kurikennn/stirling-engine/cad/step/00_assembly.STEP

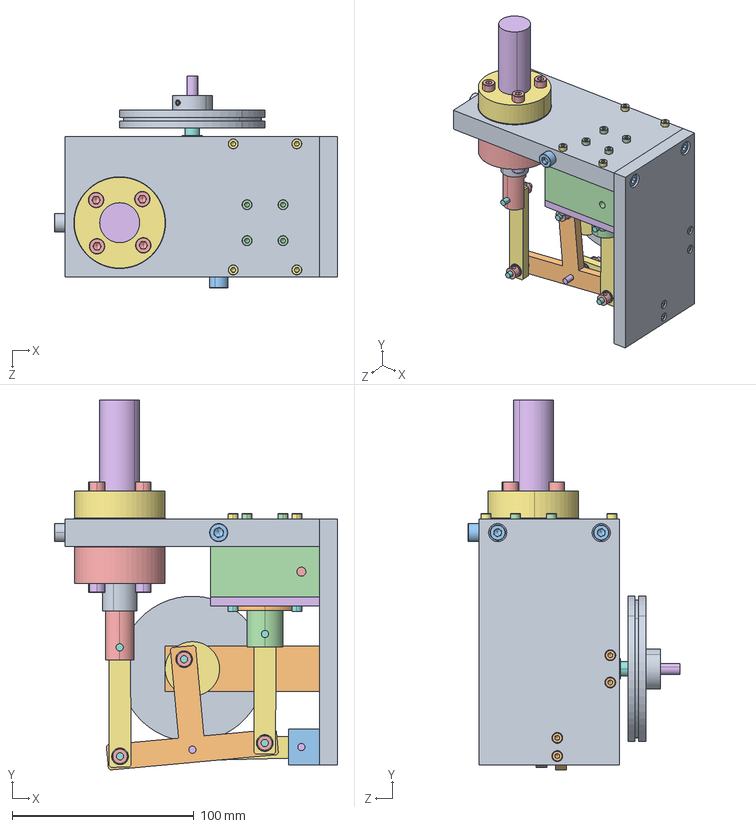
[picture p1: CAD file, 2026-09-30]
cad/step/00_assembly.STEP
156.0 x 203.7 x 116.8 mm
02_横板
09_低温部シリンダ
23_低温部ゴムパッキン
22_高温部ゴムパッキン x 2
06_高温部シリンダジャケット
07_加熱キャップ
05_加熱キャップジャケット
27_高温部シリンダ
01_ベース
11_中心軸-ベース接続部品
12_T字クランク拘束ロッド-ベース接続部品
10_低温部ピストン
08_高温部ピストンアダプタ
18_中心軸シャフト
04_クランクアーム
16_短シャフト x 5
MF84ZZ Outer Ring x 14
MF84ZZ Inner Ring x 14
MF84ZZ Shield1 x 14
MF84ZZ Ball x 168
MF84ZZ Shield2 x 14
MF106ZZ1 Outer Ring x 2
MF106ZZ1 Inner Ring x 2
MF106ZZ1 Shield1 x 2
MF106ZZ1 Ball x 32
MF106ZZ1 Shield2 x 2
20_中心軸スペーサ x 2
03_フライホイール
13_T字クランク
19_スペーサ x 3
31_シムリング x 11
32_ストッパ x 7
17_長シャフト x 2
15_ピストン駆動ロッド x 2
21_T字クランク側スペーサ x 2
14_T字クランク拘束ロッド
28_高温部ピストン
hexagon socket head cap screw_jis_JIS B 1176 M3 x 16 (16) --N x 4
hexagon socket head cap screw_jis_JIS B 1176 M5 x 16 (16) --N x 2
hexagon socket head cap screw_jis_JIS B 1176 M3 x 25 (18) --N x 4
hexagon socket head cap screw_jis_JIS B 1176 M5 x 20 (20) --N x 4
hexagon socket head cap screw_jis_JIS B 1176 M5 x 25 (25) --N x 4
hexagon socket set screw flat point_jis_JIS B 1177 Flat point M3 x 5 --N x 6
hexagon socket set screw flat point_jis_JIS B 1177 Flat point M3 x 12 --N
hexagon socket set screw flat point_jis_JIS B 1177 Flat point M3 x 6 --N
hexagon socket set screw flat point_jis_JIS B 1177 Flat point M4 x 8 --N
hexagon socket head cap screw_jis_JIS B 1176 M6 x 20 (20) --N
24_機構側水冷用板
25_ホイール側水冷用板
26_横板側水冷用板
hexagon socket head cap screw_jis_JIS B 1176 M3 x 20 (20) --N x 4
hexagon socket head cap screw_jis_JIS B 1176 M3 x 10 (10) --N x 4
hexagon socket head cap screw_jis_JIS B 1176 M6 x 25 (25) --N
