kurikennn/stirling-engine/cad/solidworks/32_ストッパ.SLDPRT

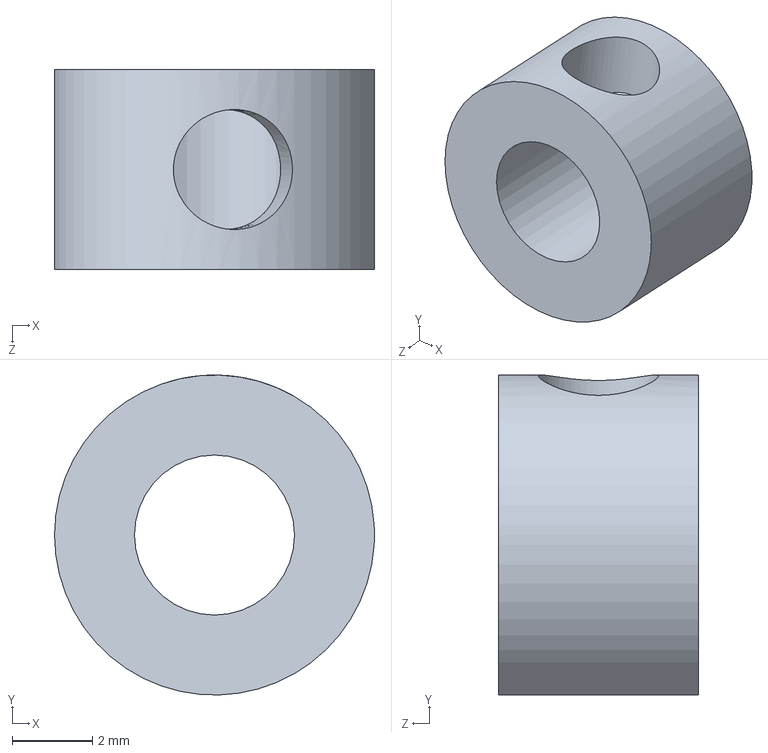
[picture p2: CAD file, 2026-09-30]
cad/solidworks/32_ストッパ.SLDPRT
8.00 x 8.00 x 5.00 mm
