kurikennn/stirling-engine/cad/step/18_center_shaft.STEP

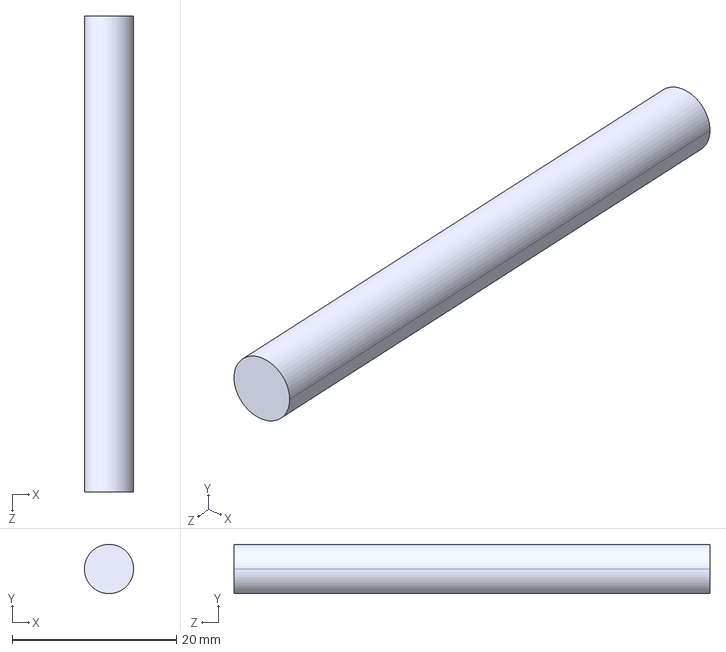
[picture p3: CAD file, 2026-09-30]
cad/step/18_center_shaft.STEP
6.00 x 6.00 x 58.0 mm
