kurikennn/stirling-engine/cad/step/07_heating_cap.STEP

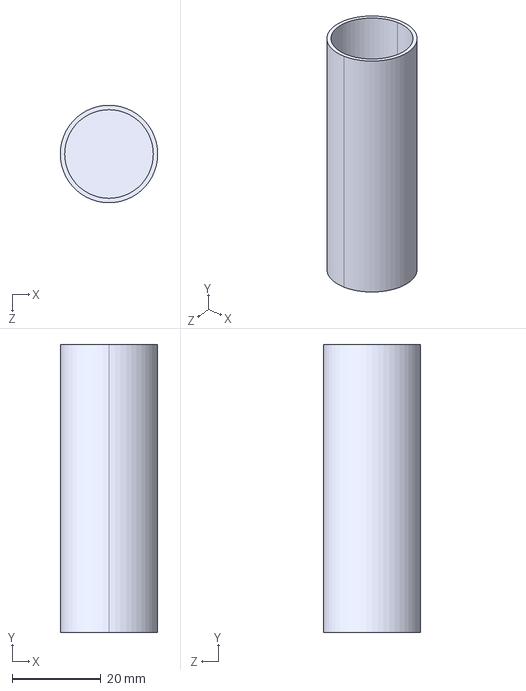
[picture p4: CAD file, 2026-09-30]
cad/step/07_heating_cap.STEP
22.0 x 65.0 x 22.0 mm
