kurikennn/stirling-engine/cad/solidworks/31_シムリング.SLDPRT

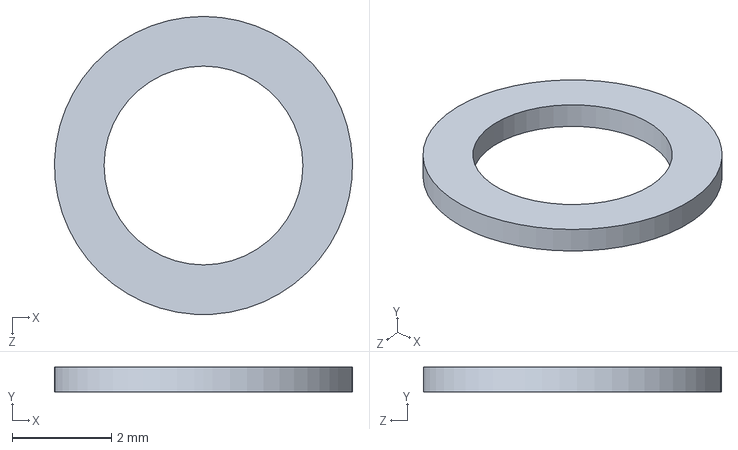
[picture p5: CAD file, 2026-09-30]
cad/solidworks/31_シムリング.SLDPRT
6.00 x 0.5 x 6.00 mm
