kurikennn/stirling-engine/cad/step/10_cold_piston.STEP

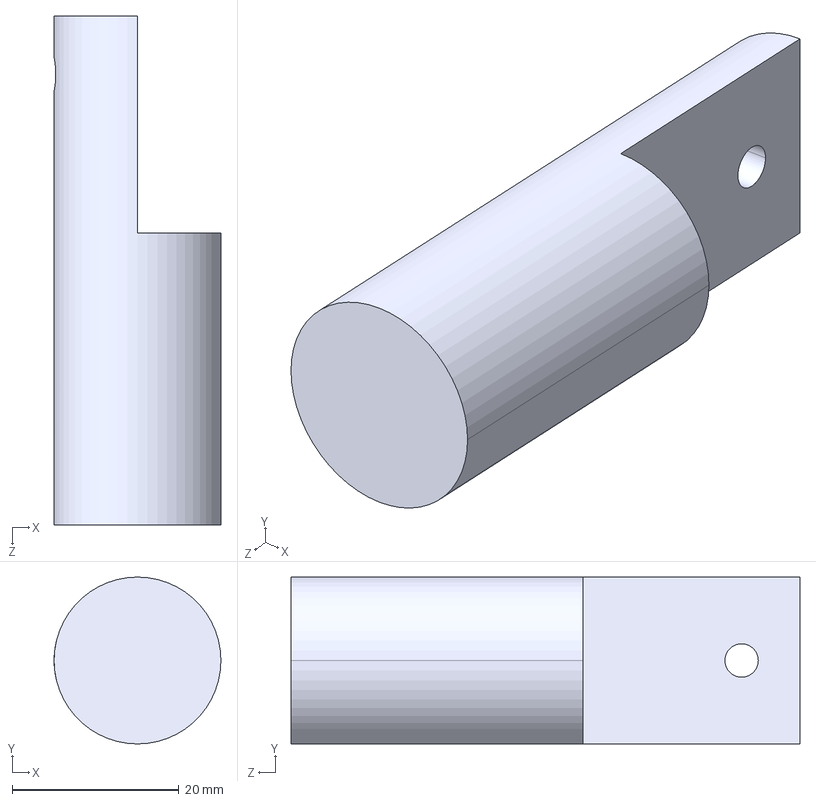
[picture p6: CAD file, 2026-09-30]
cad/step/10_cold_piston.STEP
20.0 x 20.0 x 61.0 mm
