kurikennn/stirling-engine/cad/step/20_center_spacer.STEP

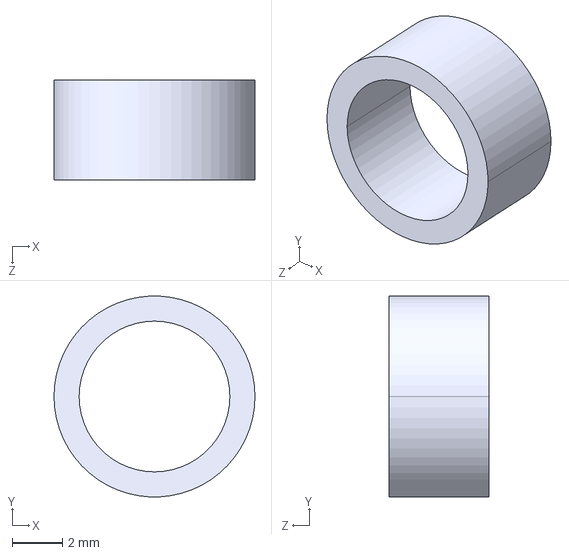
[picture p7: CAD file, 2026-09-30]
cad/step/20_center_spacer.STEP
8.00 x 7.99 x 4.00 mm
