kurikennn/stirling-engine/cad/step/01_base.STEP

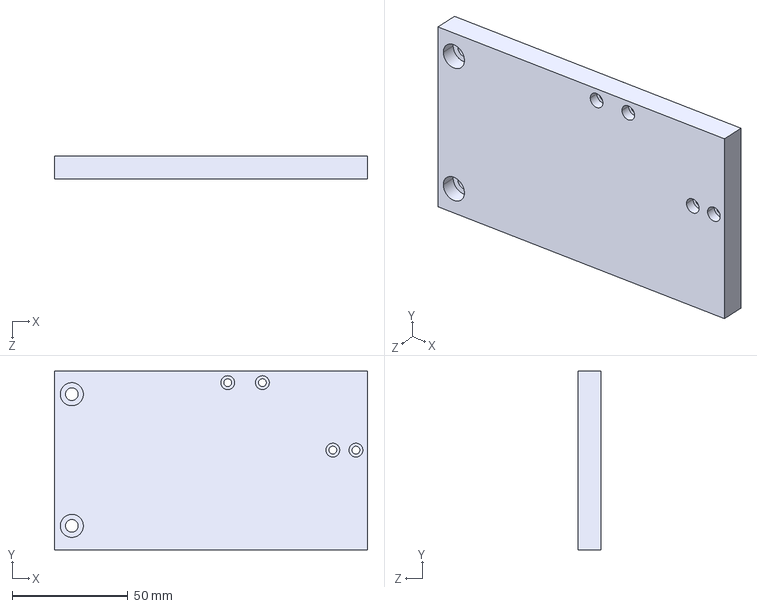
[picture p8: CAD file, 2026-09-30]
cad/step/01_base.STEP
135.5 x 77.4 x 10.0 mm
