kurikennn/stirling-engine/cad/step/12_t_crank_guide_rod_base_connector.STEP

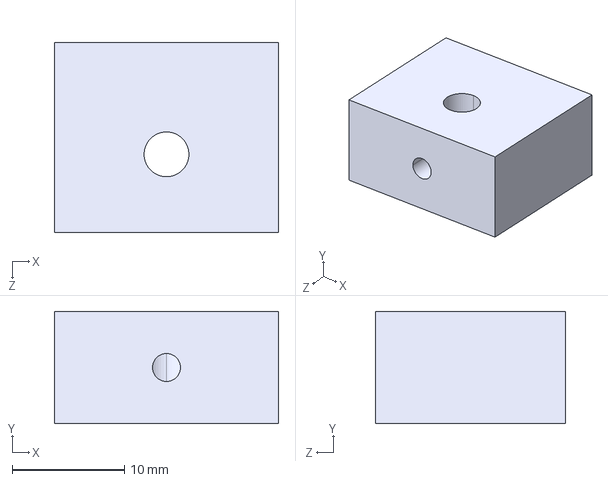
[picture p9: CAD file, 2026-09-30]
cad/step/12_t_crank_guide_rod_base_connector.STEP
20.0 x 10.0 x 17.0 mm
