kurikennn/stirling-engine/cad/step/05_heating_cap_jacket.STEP

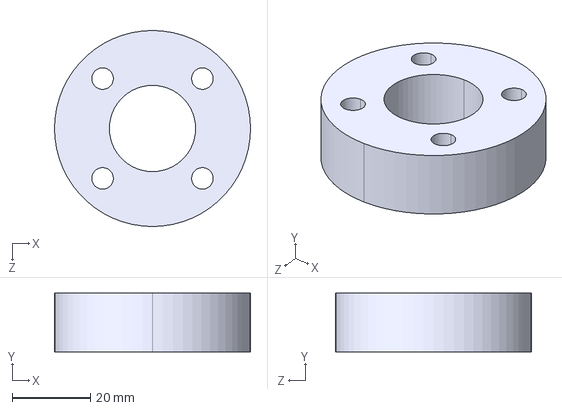
[picture p10: CAD file, 2026-09-30]
cad/step/05_heating_cap_jacket.STEP
50.0 x 15.0 x 50.0 mm
