kurikennn/stirling-engine/cad/step/25_water_cooling_plate_wheel_side.STEP

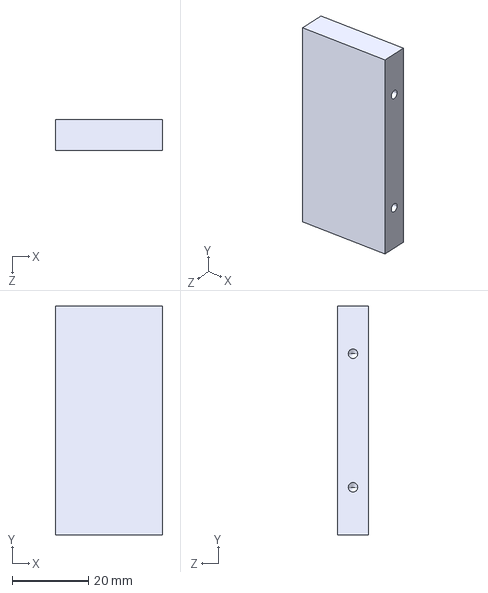
[picture p11: CAD file, 2026-09-30]
cad/step/25_water_cooling_plate_wheel_side.STEP
28.0 x 60.0 x 8.00 mm
