kurikennn/stirling-engine/cad/step/14_t_crank_guide_rod.STEP

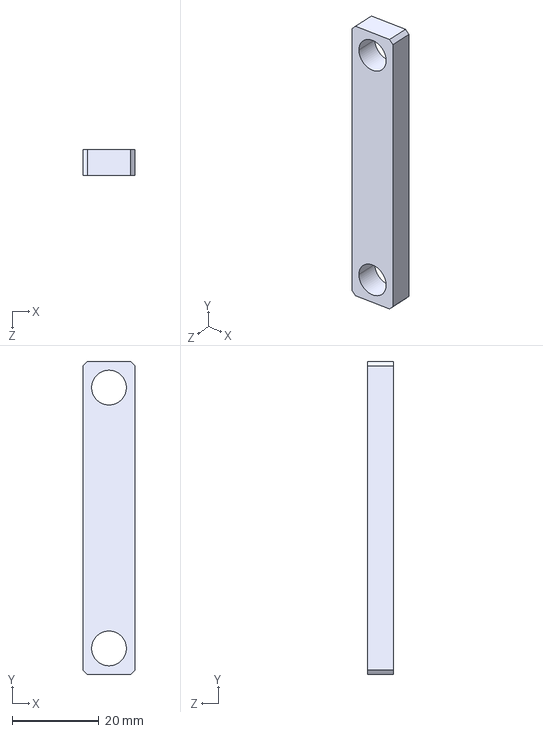
[picture p12: CAD file, 2026-09-30]
cad/step/14_t_crank_guide_rod.STEP
12.0 x 72.0 x 6.00 mm
