kurikennn/stirling-engine/cad/step/19_spacer.STEP

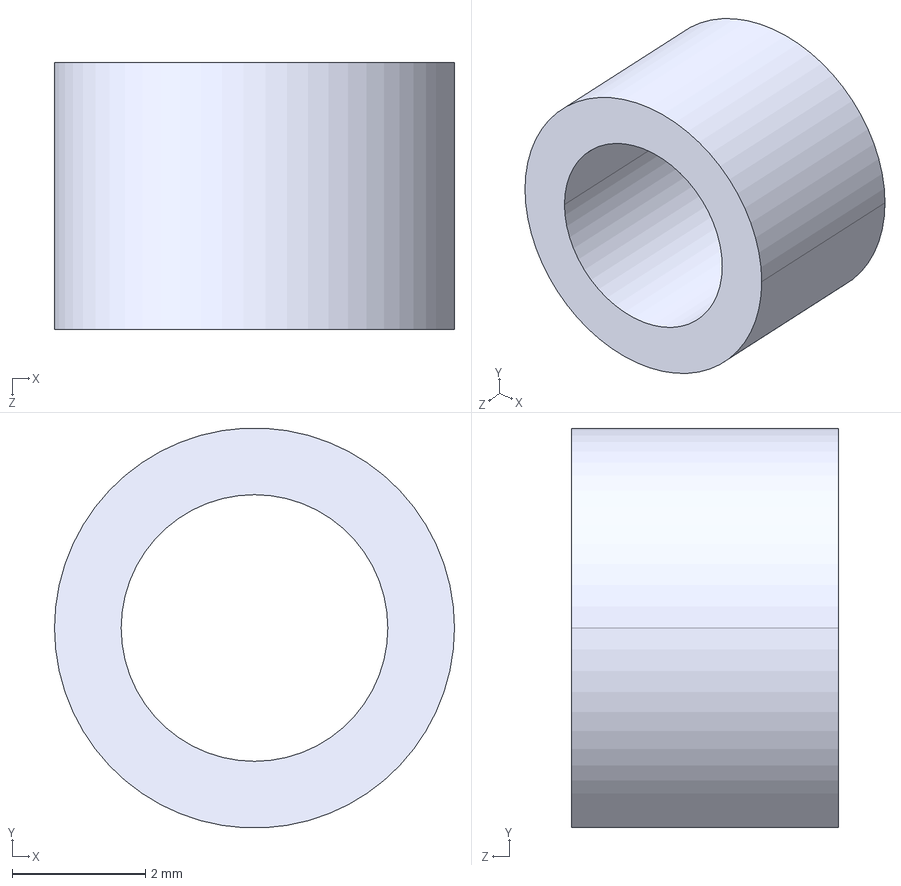
[picture p13: CAD file, 2026-09-30]
cad/step/19_spacer.STEP
6.00 x 5.99 x 4.00 mm
