kurikennn/stirling-engine/cad/step/21_spacer_t_crank_side.STEP

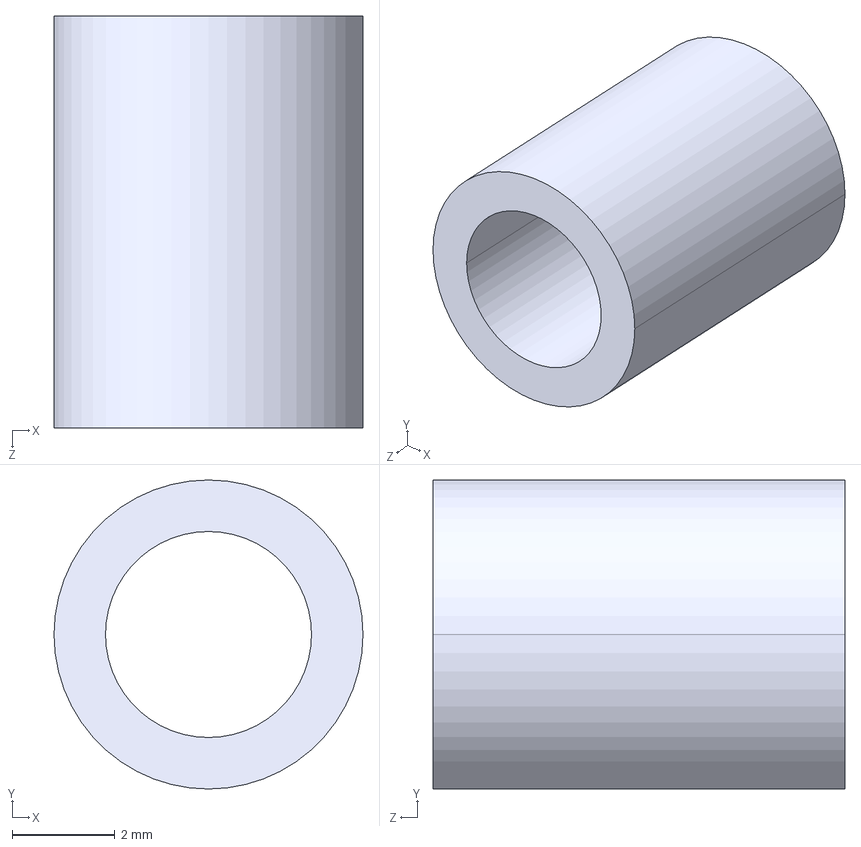
[picture p14: CAD file, 2026-09-30]
cad/step/21_spacer_t_crank_side.STEP
6.00 x 6.00 x 8.00 mm
