kurikennn/stirling-engine/cad/step/22_hot_seal.STEP

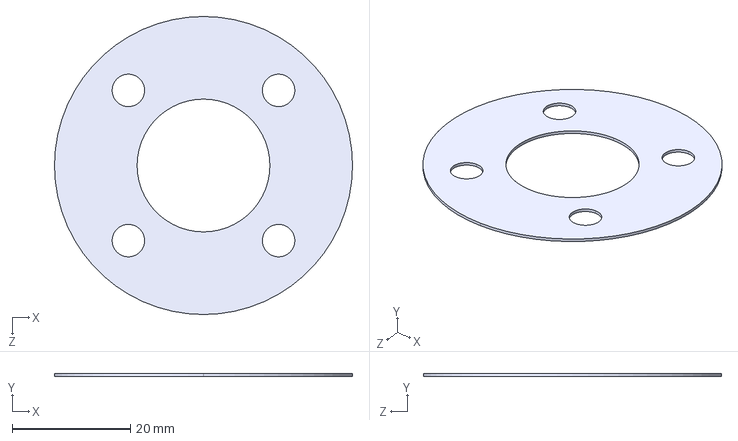
[picture p15: CAD file, 2026-09-30]
cad/step/22_hot_seal.STEP
50.5 x 0.5 x 50.5 mm
