kurikennn/stirling-engine/cad/step/16_shoft_shaft.STEP

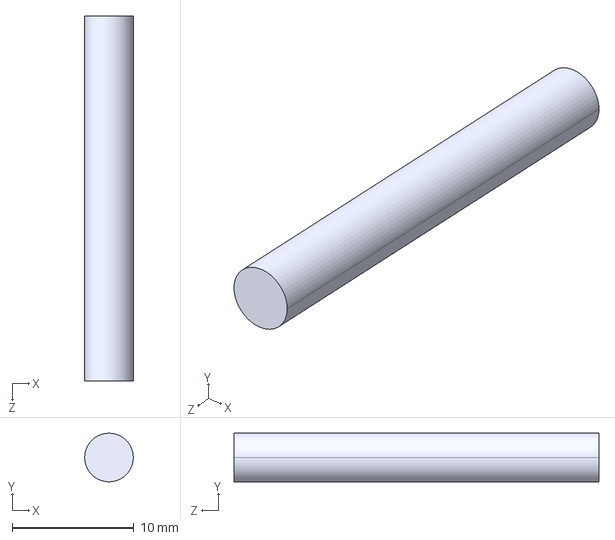
[picture p16: CAD file, 2026-09-30]
cad/step/16_shoft_shaft.STEP
4.00 x 4.00 x 30.0 mm
