kurikennn/stirling-engine/cad/step/04_crank_arm.STEP

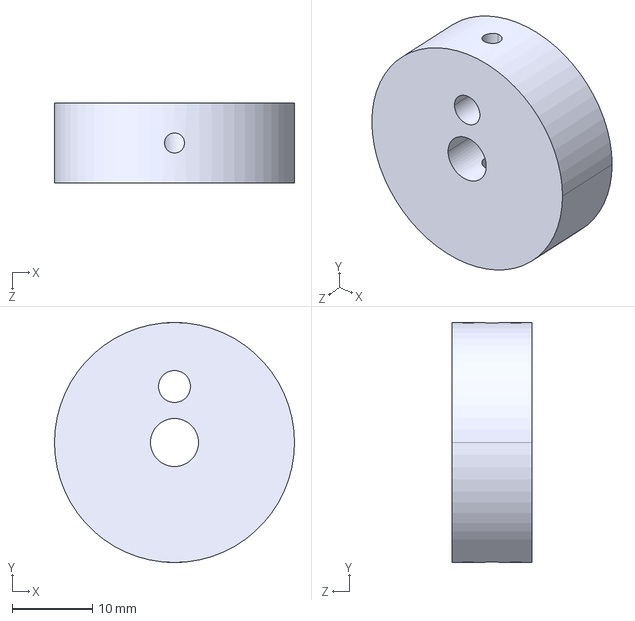
[picture p17: CAD file, 2026-09-30]
cad/step/04_crank_arm.STEP
30.0 x 30.0 x 10.0 mm
