kurikennn/stirling-engine/cad/step/03_flywheel.STEP

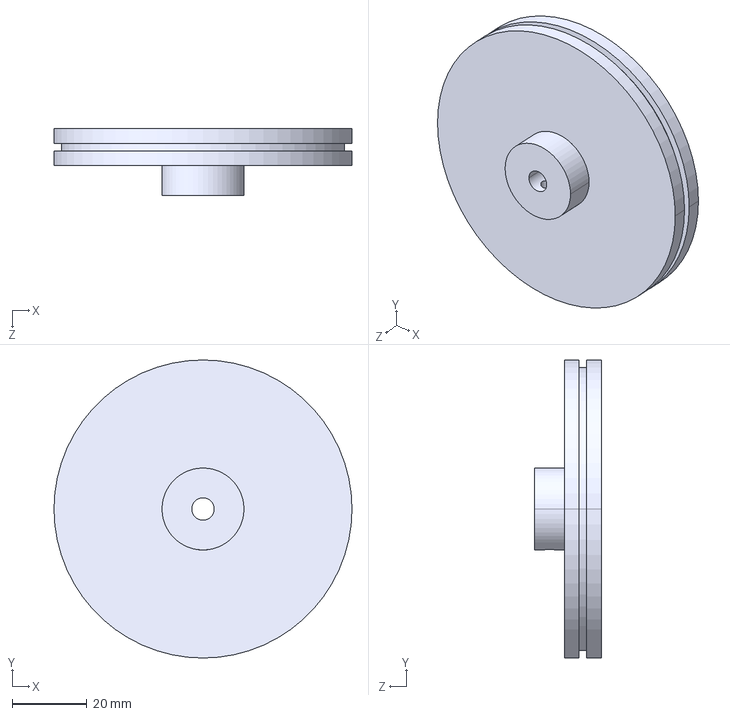
[picture p18: CAD file, 2026-09-30]
cad/step/03_flywheel.STEP
80.0 x 80.0 x 18.0 mm
