kurikennn/stirling-engine/cad/step/27_hot_cylinder.STEP

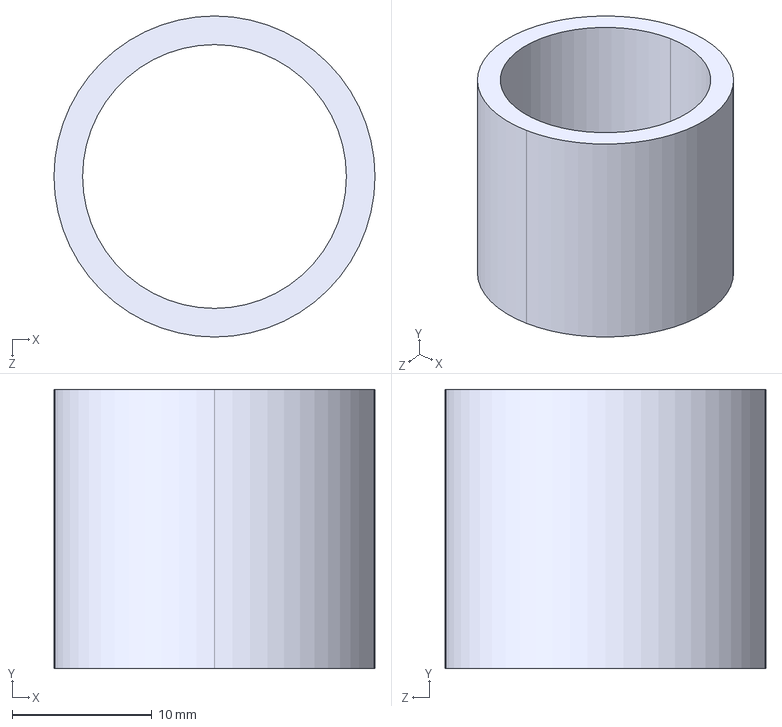
[picture p19: CAD file, 2026-09-30]
cad/step/27_hot_cylinder.STEP
23.0 x 20.0 x 23.0 mm
