kurikennn/stirling-engine/cad/step/02_side_plate.STEP

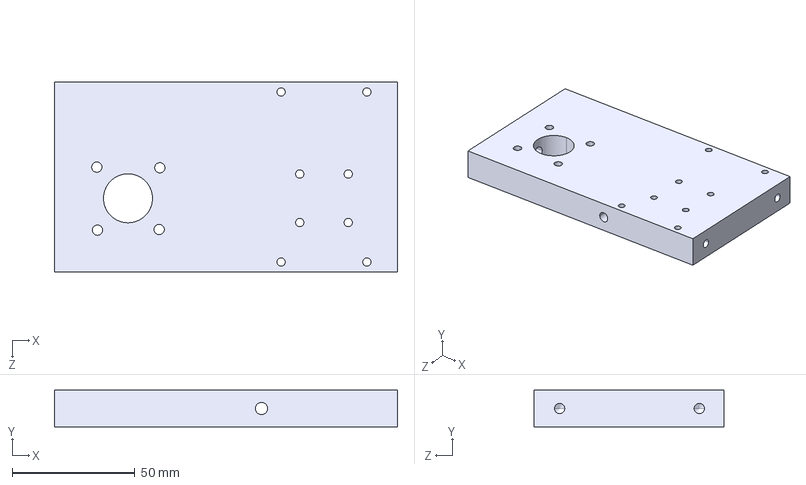
[picture p20: CAD file, 2026-09-30]
cad/step/02_side_plate.STEP
140.0 x 15.0 x 77.4 mm
