kurikennn/stirling-engine/cad/step/11_center_shaft_base_connector.STEP

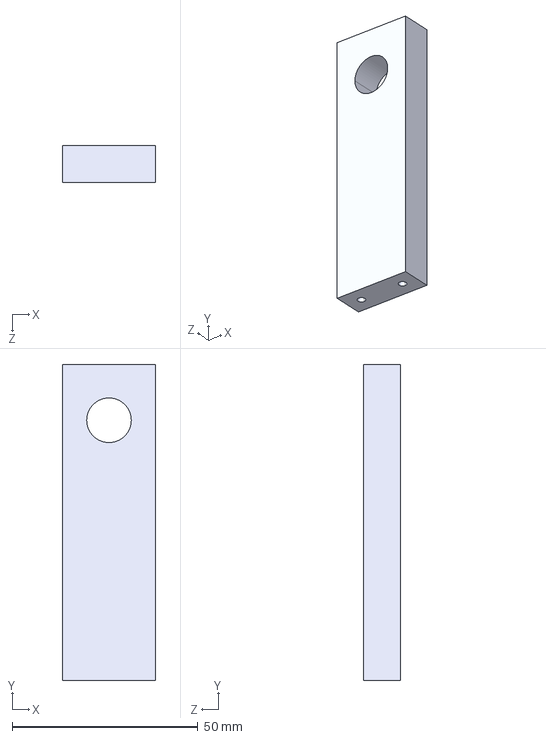
[picture p21: CAD file, 2026-09-30]
cad/step/11_center_shaft_base_connector.STEP
25.0 x 85.0 x 10.0 mm
