kurikennn/stirling-engine/cad/step/28_hot_piston.STEP

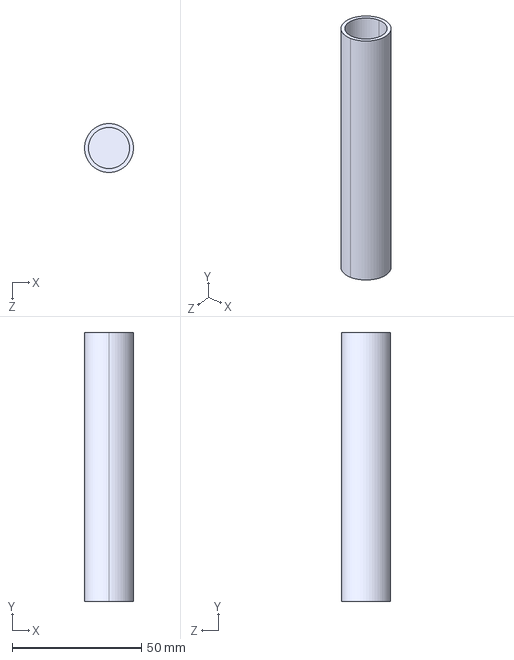
[picture p22: CAD file, 2026-09-30]
cad/step/28_hot_piston.STEP
18.9 x 104.0 x 18.9 mm
