kurikennn/stirling-engine/cad/step/26_water_cooling_plate_side_plate_side.STEP

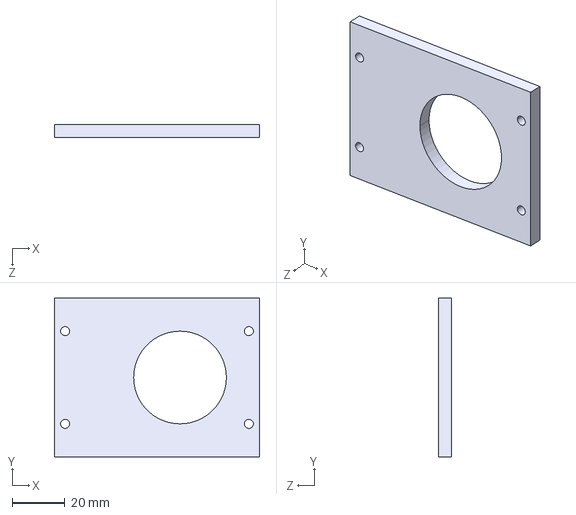
[picture p23: CAD file, 2026-09-30]
cad/step/26_water_cooling_plate_side_plate_side.STEP
77.4 x 60.0 x 5.00 mm
