kurikennn/stirling-engine/cad/step/24_water_cooling_plate_mechanism_side.STEP

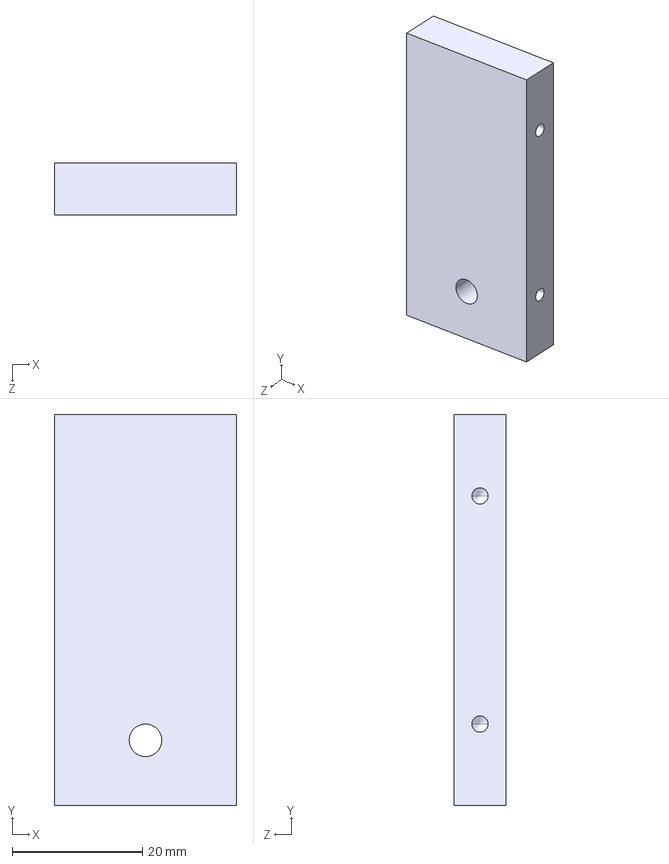
[picture p24: CAD file, 2026-09-30]
cad/step/24_water_cooling_plate_mechanism_side.STEP
28.0 x 60.0 x 8.00 mm
