kurikennn/stirling-engine/cad/step/09_cold_cylinder.STEP

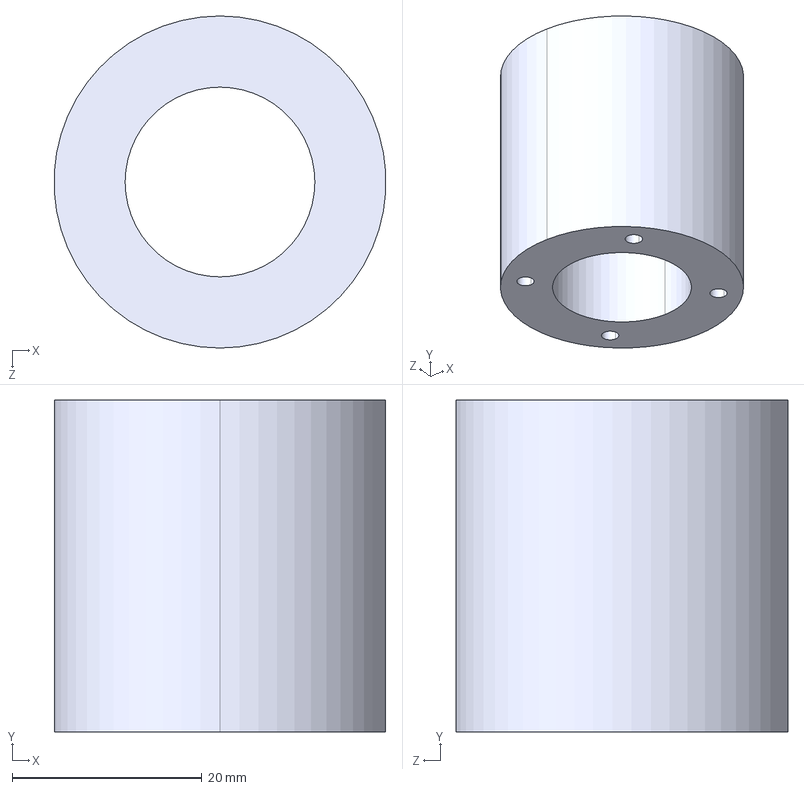
[picture p25: CAD file, 2026-09-30]
cad/step/09_cold_cylinder.STEP
34.9 x 35.0 x 35.0 mm
