kurikennn/stirling-engine/cad/step/23_cold_seal.STEP

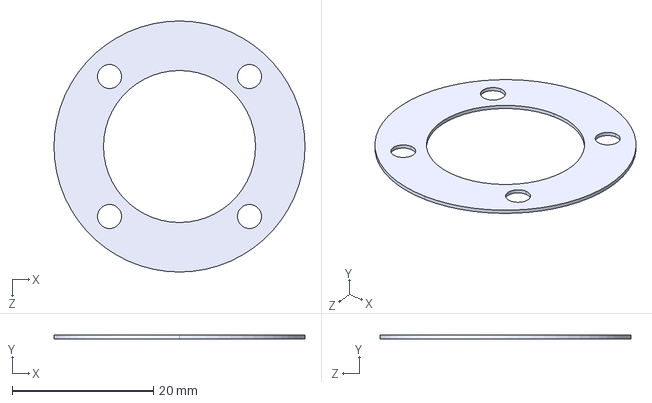
[picture p26: CAD file, 2026-09-30]
cad/step/23_cold_seal.STEP
35.5 x 0.5 x 35.5 mm
