kurikennn/stirling-engine/cad/step/13_t_crank.STEP

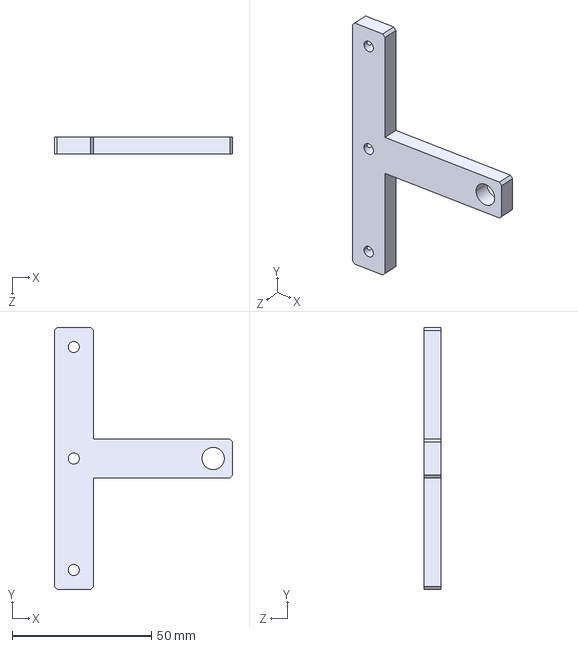
[picture p27: CAD file, 2026-09-30]
cad/step/13_t_crank.STEP
64.0 x 94.0 x 6.00 mm
