kurikennn/stirling-engine/cad/step/06_hot_cylinder_jacket.STEP

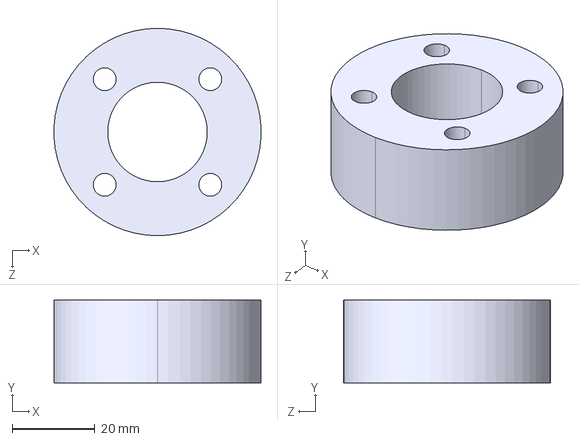
[picture p28: CAD file, 2026-09-30]
cad/step/06_hot_cylinder_jacket.STEP
49.9 x 20.0 x 50.0 mm
