kurikennn/stirling-engine/cad/step/08_hot_piston_adapter.STEP

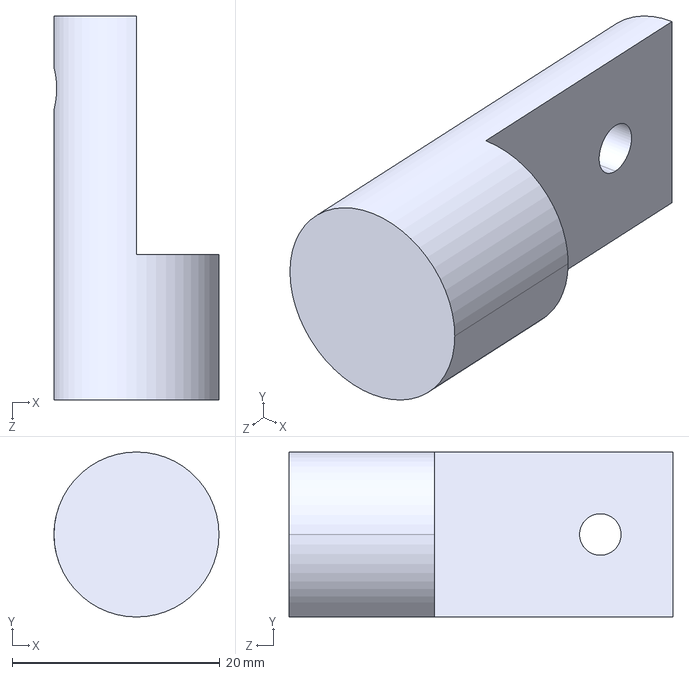
[picture p29: CAD file, 2026-09-30]
cad/step/08_hot_piston_adapter.STEP
15.9 x 15.9 x 37.0 mm
