kurikennn/stirling-engine/cad/step/17_long_shaft.STEP

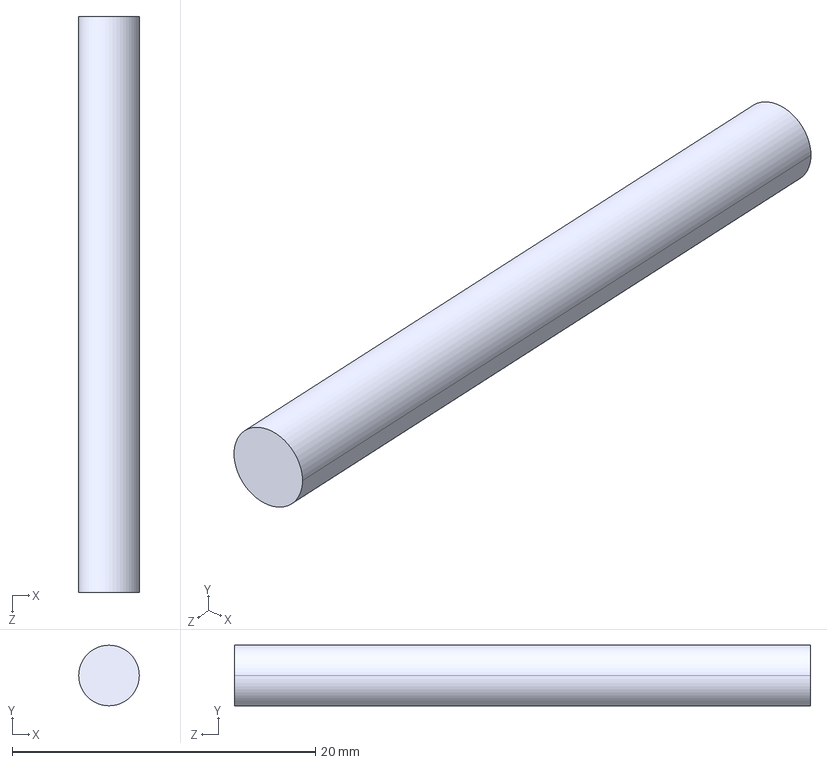
[picture p30: CAD file, 2026-09-30]
cad/step/17_long_shaft.STEP
4.00 x 4.00 x 38.0 mm
