kurikennn/stirling-engine/cad/solidworks/横板_サブアセンブリ.SLDASM

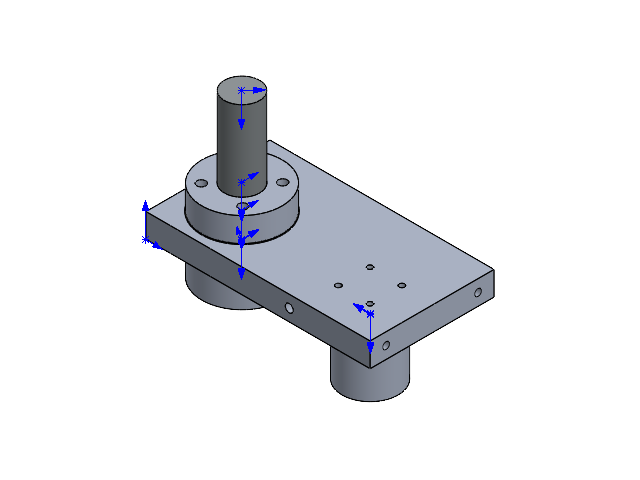
[picture p31: CAD file, 2026-09-30]
cad/solidworks/横板_サブアセンブリ.SLDASM
02_横板
09_低温部シリンダ
23_低温部ゴムパッキン
22_高温部ゴムパッキン x 2
06_高温部シリンダジャケット
07_加熱キャップ
05_加熱キャップジャケット
27_高温部シリンダ
