kurikennn/stirling-engine/cad/solidworks/MF106ZZ/30_ベアリングMF106ZZ1.sldasm

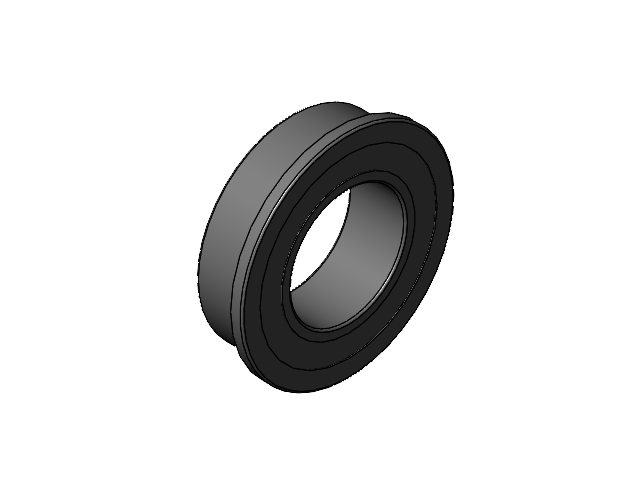
[picture p32: CAD file, 2026-09-30]
cad/solidworks/MF106ZZ/30_ベアリングMF106ZZ1.sldasm
MF106ZZ1 Outer Ring
MF106ZZ1 Inner Ring
MF106ZZ1 Shield1
MF106ZZ1 Ball x 16
MF106ZZ1 Shield2
