kurikennn/stirling-engine/cad/solidworks/MF84ZZ/29_ベアリングMF84ZZ.sldasm

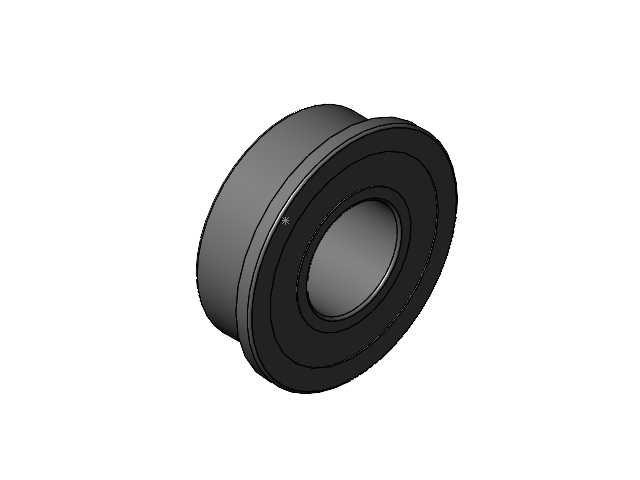
[picture p33: CAD file, 2026-09-30]
cad/solidworks/MF84ZZ/29_ベアリングMF84ZZ.sldasm
MF84ZZ Outer Ring
MF84ZZ Inner Ring
MF84ZZ Shield1
MF84ZZ Ball x 12
MF84ZZ Shield2
