kurikennn/stirling-engine/cad/solidworks/クランクアーム_サブアセンブリ.SLDASM

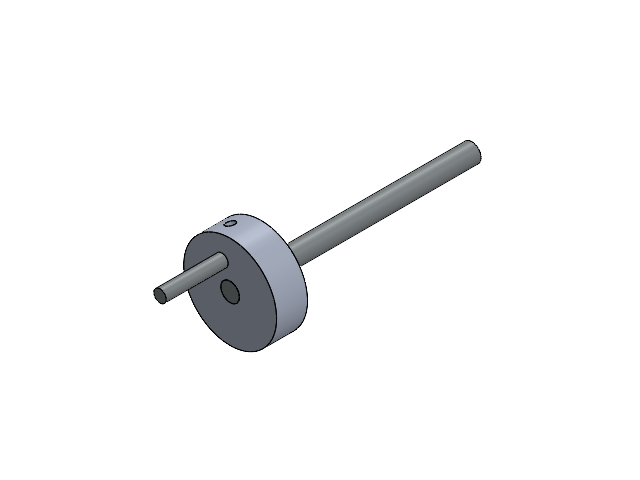
[picture p34: CAD file, 2026-09-30]
cad/solidworks/クランクアーム_サブアセンブリ.SLDASM
18_中心軸シャフト
04_クランクアーム
16_短シャフト
