kurikennn/stirling-engine/cad/solidworks/水冷箱_サブアセンブリ.SLDASM

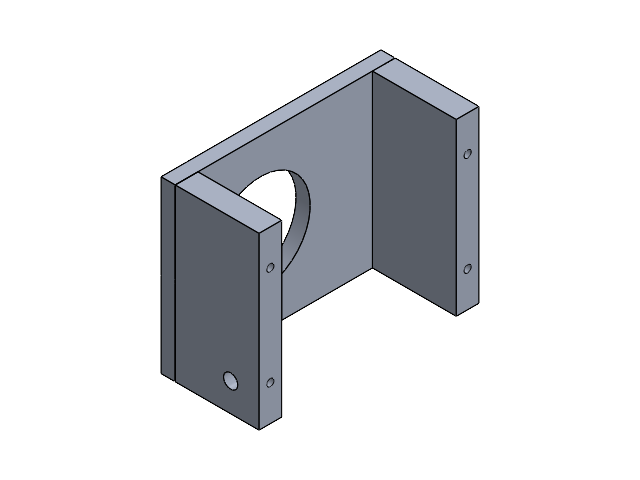
[picture p35: CAD file, 2026-09-30]
cad/solidworks/水冷箱_サブアセンブリ.SLDASM
24_機構側水冷用板
25_ホイール側水冷用板
26_横板側水冷用板
