kurikennn/stirling-engine/(list of files, cad)

Other CAD files:
cad/solidworks/MF106ZZ/MF106ZZ1 Outer Ring.sldprt
cad/solidworks/MF84ZZ/MF84ZZ Shield2.sldprt
cad/solidworks/MF106ZZ/MF106ZZ1 Inner Ring.sldprt
cad/solidworks/MF84ZZ/MF84ZZ Ball.sldprt
cad/solidworks/MF84ZZ/MF84ZZ Outer Ring.sldprt
cad/solidworks/MF106ZZ/MF106ZZ1 Shield2.sldprt
cad/solidworks/MF106ZZ/MF106ZZ1 Ball.sldprt
cad/solidworks/MF84ZZ/MF84ZZ Inner Ring.sldprt
cad/solidworks/MF106ZZ/MF106ZZ1 Shield1.sldprt
cad/solidworks/MF84ZZ/MF84ZZ Shield1.sldprt
cad/step/15_piston_drive_rod.STEP
cad/solidworks/00_assembly.SLDASM
cad/solidworks/01_base.SLDPRT
cad/solidworks/02_side_plate.SLDPRT
cad/solidworks/03_flywheel.SLDPRT
cad/solidworks/04_crank_arm.SLDPRT
cad/solidworks/05_heating_cap_jacket.SLDPRT
cad/solidworks/06_hot_cylinder_jacket.SLDPRT
cad/solidworks/07_heating_cap.SLDPRT
cad/solidworks/08_hot_piston_adapter.SLDPRT
cad/solidworks/09_cold_cylinder.SLDPRT
cad/solidworks/10_cold_piston.SLDPRT
cad/solidworks/11_center_shaft_base_connector.SLDPRT
cad/solidworks/12_t_crank_guide_rod_base_connector.SLDPRT
cad/solidworks/13_t_crank.SLDPRT
cad/solidworks/14_t_crank_guide_rod.SLDPRT
cad/solidworks/15_piston_drive_rod.SLDPRT
cad/solidworks/16_shoft_shaft.SLDPRT
cad/solidworks/17_long_shaft.SLDPRT
cad/solidworks/18_center_shaft.SLDPRT
cad/solidworks/19_spacer.SLDPRT
cad/solidworks/20_center_spacer.SLDPRT
cad/solidworks/21_spacer_t_crank_side.SLDPRT
cad/solidworks/22_hot_seal.SLDPRT
cad/solidworks/23_cold_seal.SLDPRT
cad/solidworks/24_water_cooling_plate_mechanism_side.SLDPRT
cad/solidworks/25_water_cooling_plate_wheel_side.SLDPRT
cad/solidworks/26_water_cooling_plate_side_plate_side.SLDPRT
cad/solidworks/27_hot_cylinder.SLDPRT
cad/solidworks/28_hot_piston.SLDPRT
