kurikennn/stirling-engine/drawings/pdf/00_assembly.pdf

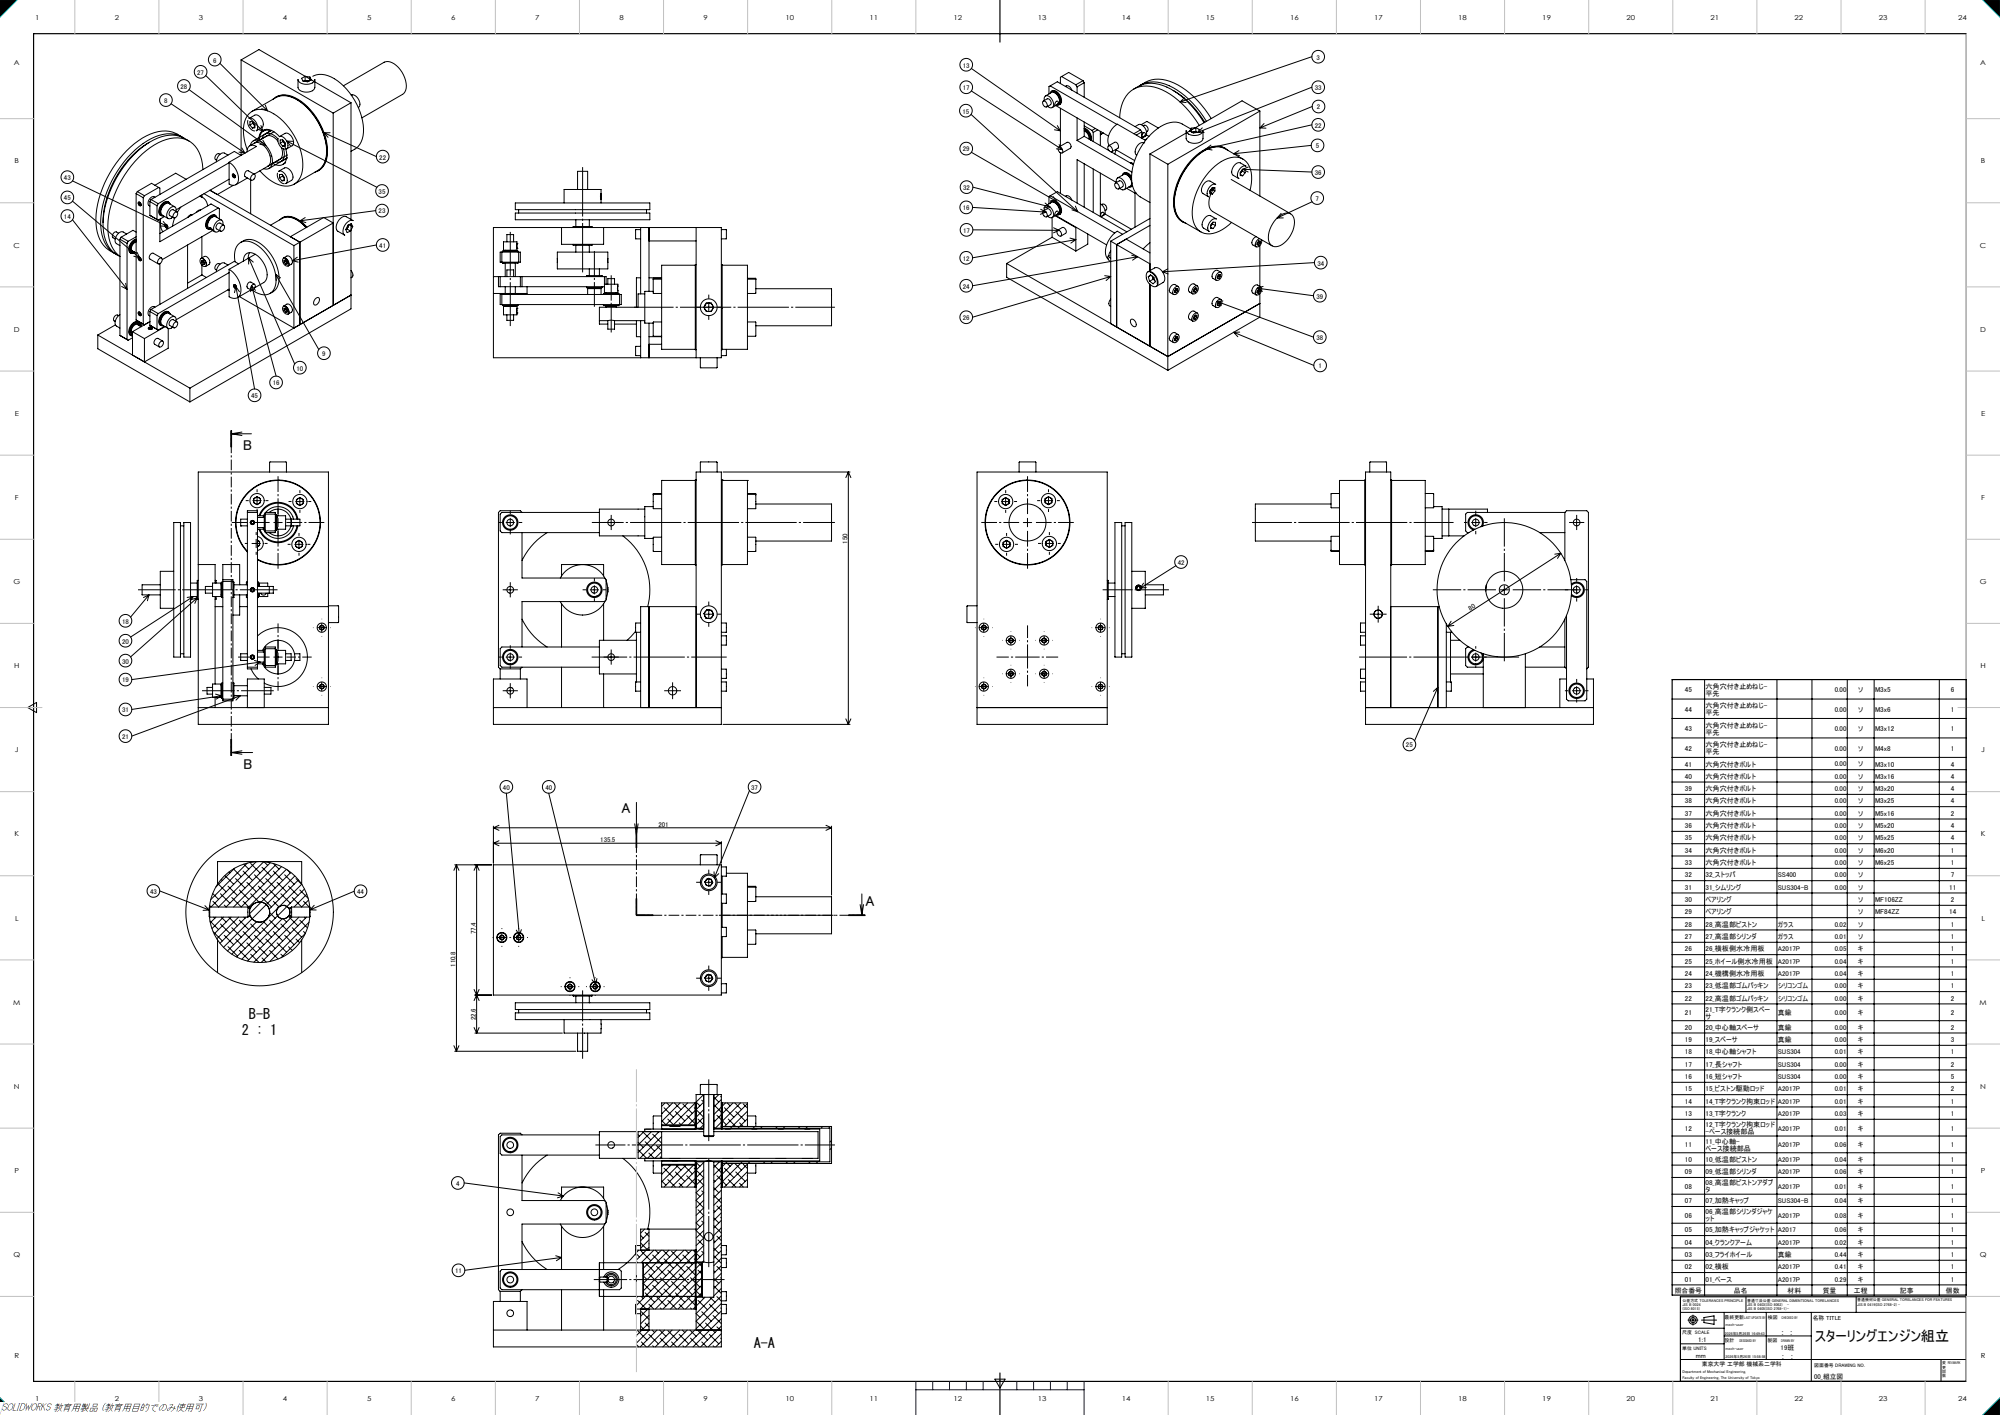
[picture p36: page 1]
25_ホイール側水冷用板 A2017P; 21_T字クランク側スペー サ; 14_T字クランク拘束ロッド A2017P; 08_高温部ピストンアダプ タ; 05_加熱キャップジャケット A2017; 尺度 SCALE; 設計 DESIGNED BY; 製図 DRAWN BY; 名称 TITLE; - JIS B 0419(ISO 2768-2)

公差方式 TOLERANCES PRINCIPLE
JIS B 0024
(ISO 8015)

普通寸法公差 GENERAL DIMENTIONAL TORELANCES
JIS B 0403(ISO 8062)
JIS B 0405(ISO 2768-1)

普通幾何公差 GENERAL TORELANCES FOR FEATURES

最終更新 LAST UPDATE BY

検図 CHECKED BY

単位 UNITS
東京大学 工学部 機械系二学科

図面番号 DRAWING NO.
00_組立図

Department of Mechanical Engineering,
Faculty of Engineering, The University of Tokyo
