kurikennn/stirling-engine/drawings/pdf/12_t_crank_guide_rod_base_connector.pdf

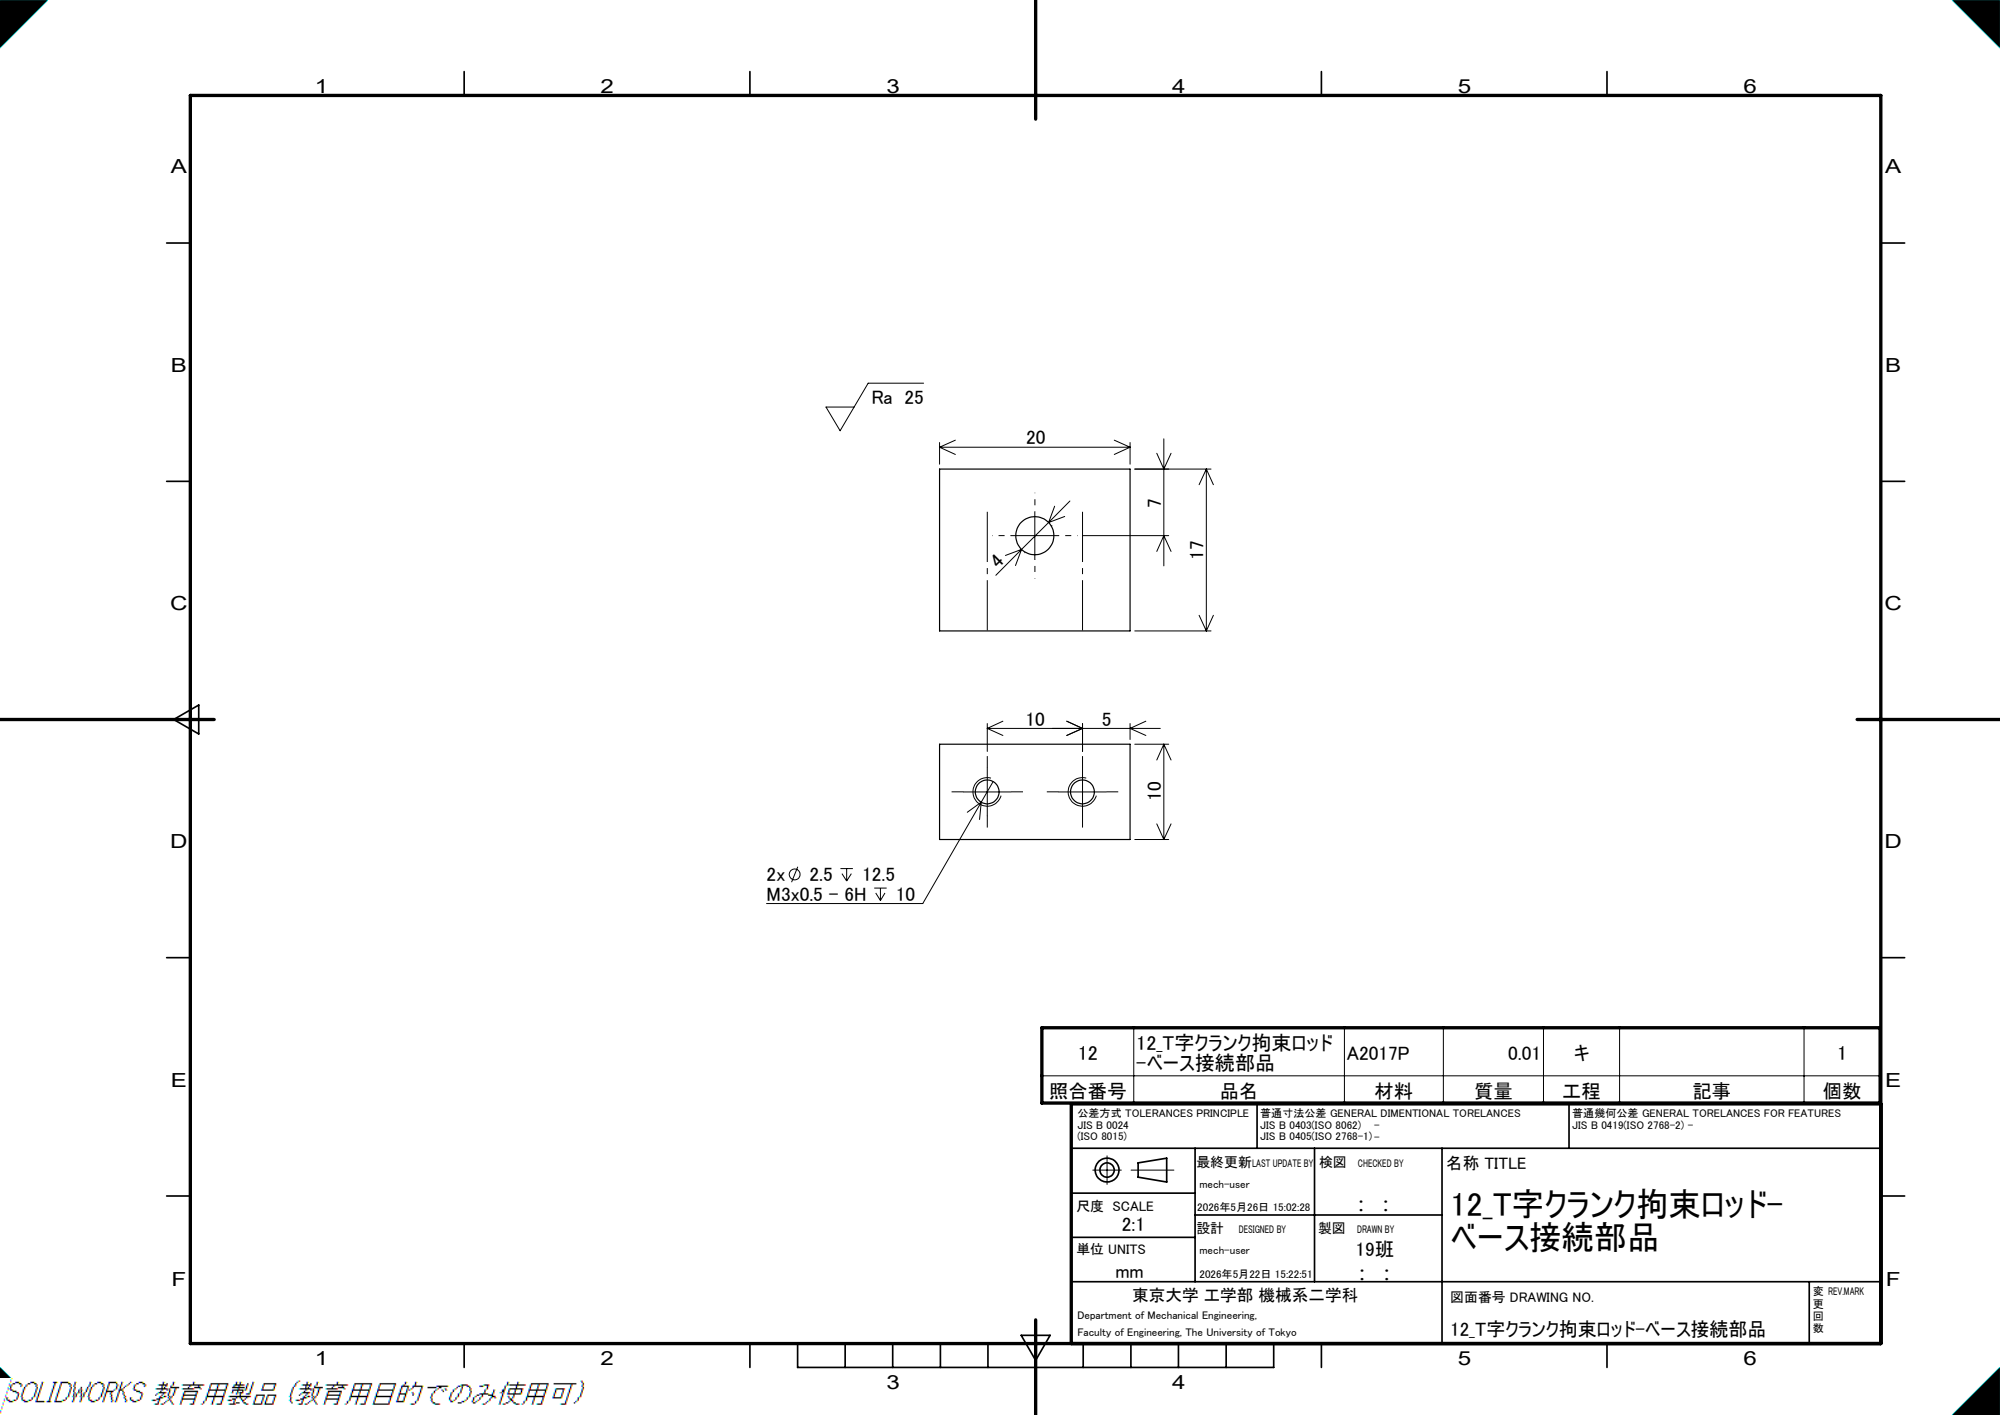
[picture p37: page 1]
尺度 SCALE; 設計 DESIGNED BY; 製図 DRAWN BY; 名称 TITLE; - JIS B 0419(ISO 2768-2)

12 | 12_T字クランク拘束ロッド -ベース接続部品 | A2017P | 0.01 | キ | | 1

照合番号 | 品名 | 材料 | 質量 | 工程 | 記事 | 個数

公差方式 TOLERANCES PRINCIPLE
JIS B 0024
(ISO 8015)

普通寸法公差 GENERAL DIMENTIONAL TORELANCES
JIS B 0403(ISO 8062)
JIS B 0405(ISO 2768-1)

普通幾何公差 GENERAL TORELANCES FOR FEATURES

最終更新 LAST UPDATE BY

検図 CHECKED BY

単位 UNITS
東京大学 工学部 機械系二学科

図面番号 DRAWING NO.
12_T字クランク拘束ロッド-ベース接続部品

Department of Mechanical Engineering,
Faculty of Engineering, The University of Tokyo
