kurikennn/stirling-engine/drawings/pdf/16_17_18_shafts.pdf

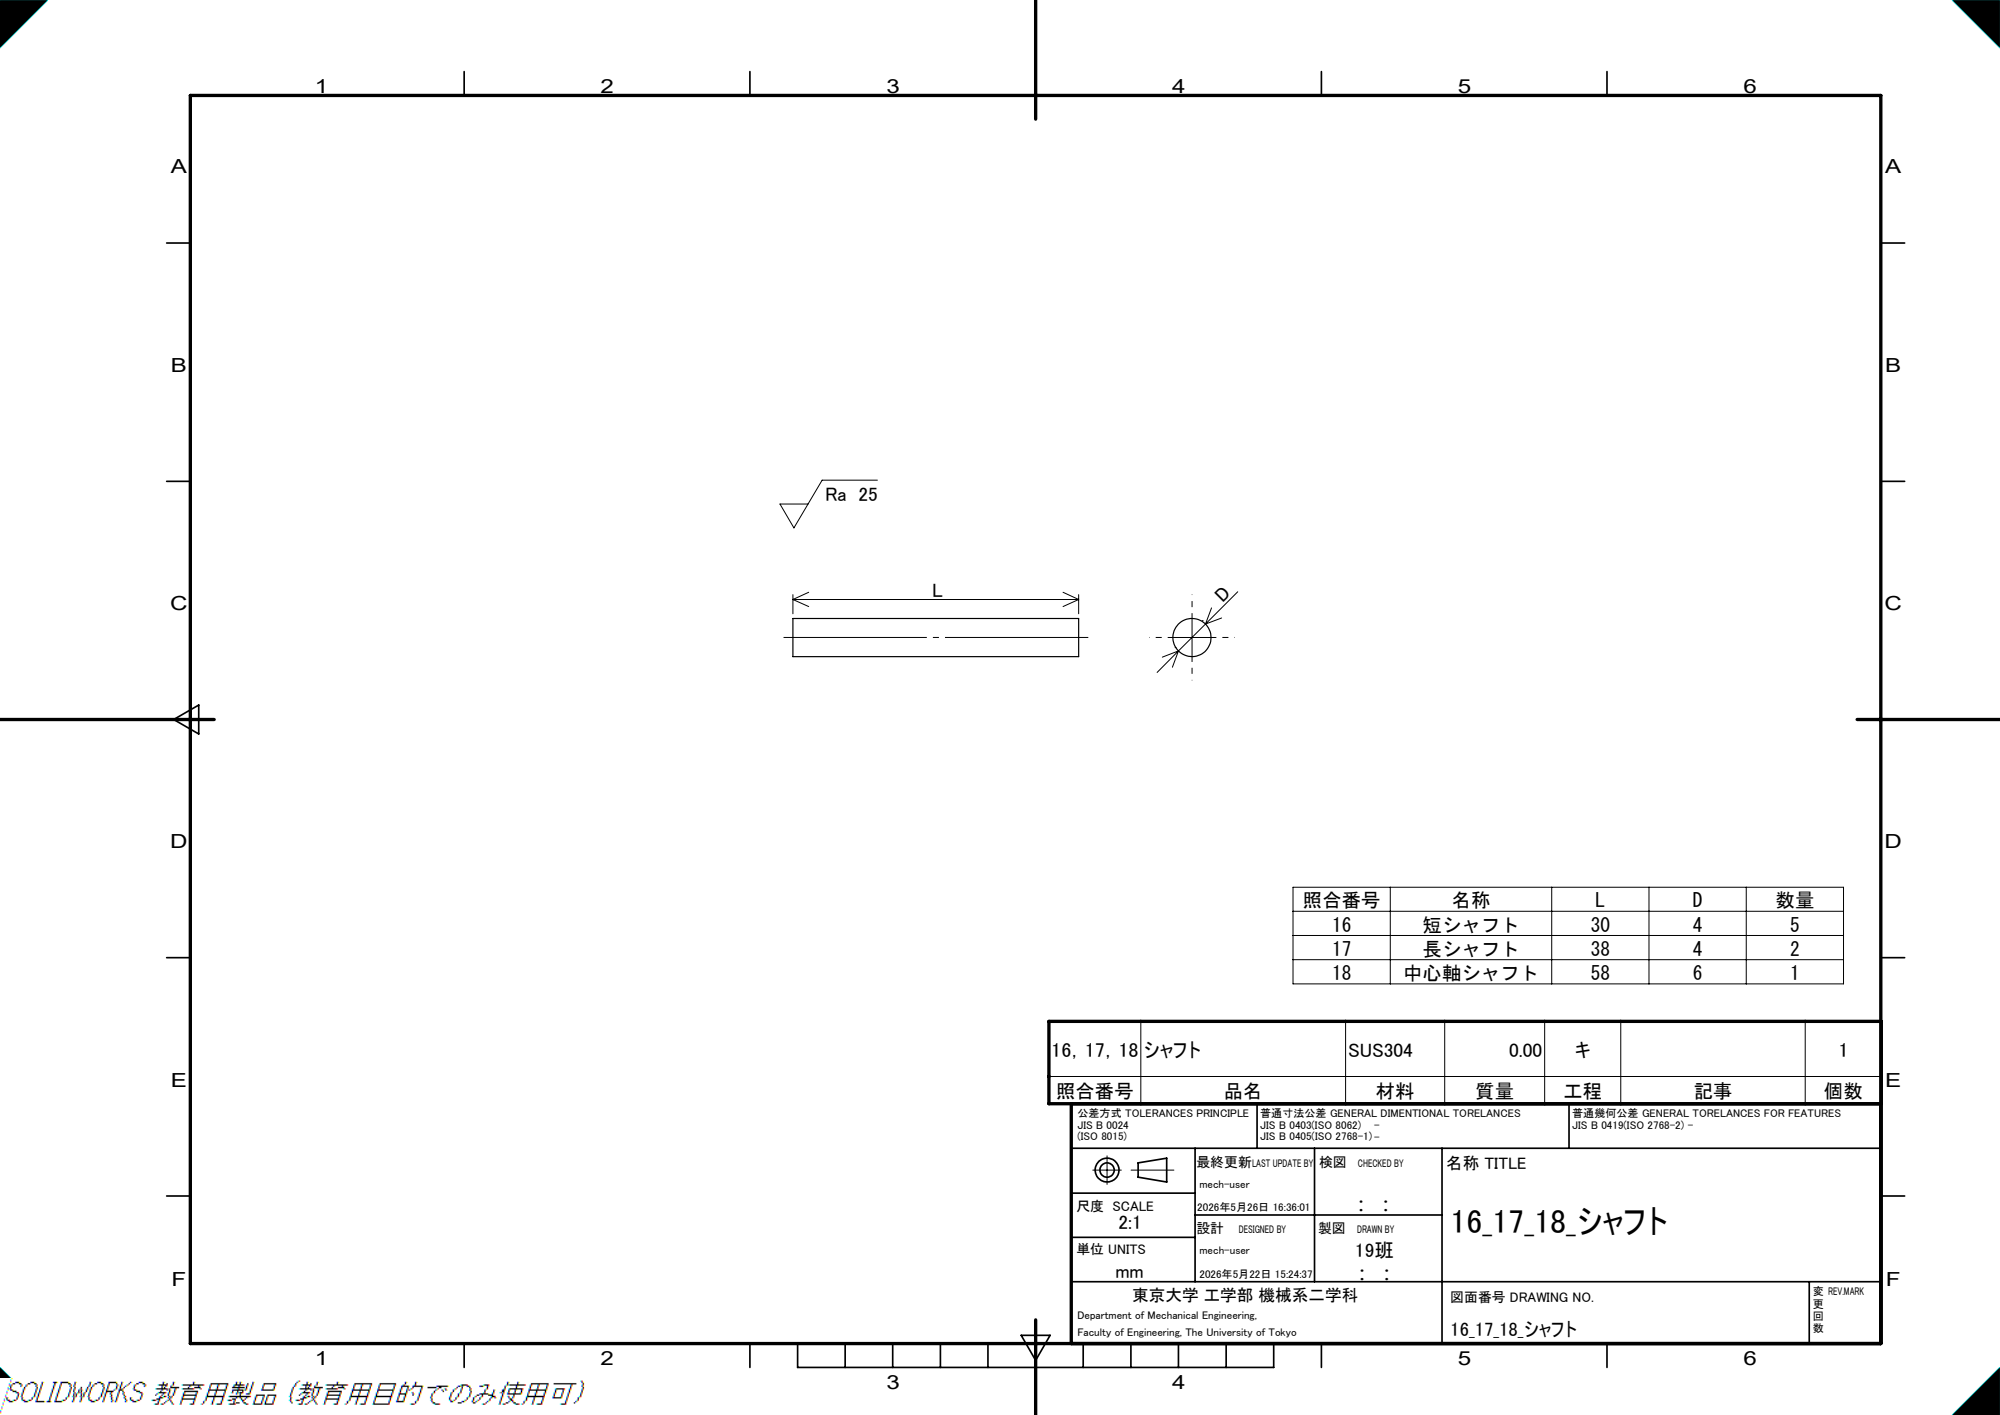
[picture p38: page 1]
尺度 SCALE; 設計 DESIGNED BY; 製図 DRAWN BY; 名称 TITLE; - JIS B 0419(ISO 2768-2)

照合番号 | 名称 | L | D | 数量
16 | 短シャフト | 30 | 4 | 5
17 | 長シャフト | 38 | 4 | 2
18 | 中心軸シャフト | 58 | 6 | 1

16，17，18 シャフト | | SUS304 | 0.00 | キ | | 1

照合番号 | 品名 | 材料 | 質量 | 工程 | 記事 | 個数

公差方式 TOLERANCES PRINCIPLE
JIS B 0024
(ISO 8015)

普通寸法公差 GENERAL DIMENTIONAL TORELANCES
JIS B 0403(ISO 8062)
JIS B 0405(ISO 2768-1)

普通幾何公差 GENERAL TORELANCES FOR FEATURES

最終更新 LAST UPDATE BY

検図 CHECKED BY

単位 UNITS
東京大学 工学部 機械系二学科

図面番号 DRAWING NO.
16_17_18_シャフト

Department of Mechanical Engineering,
Faculty of Engineering, The University of Tokyo
