kurikennn/stirling-engine/drawings/pdf/19_20_21_spacers.pdf

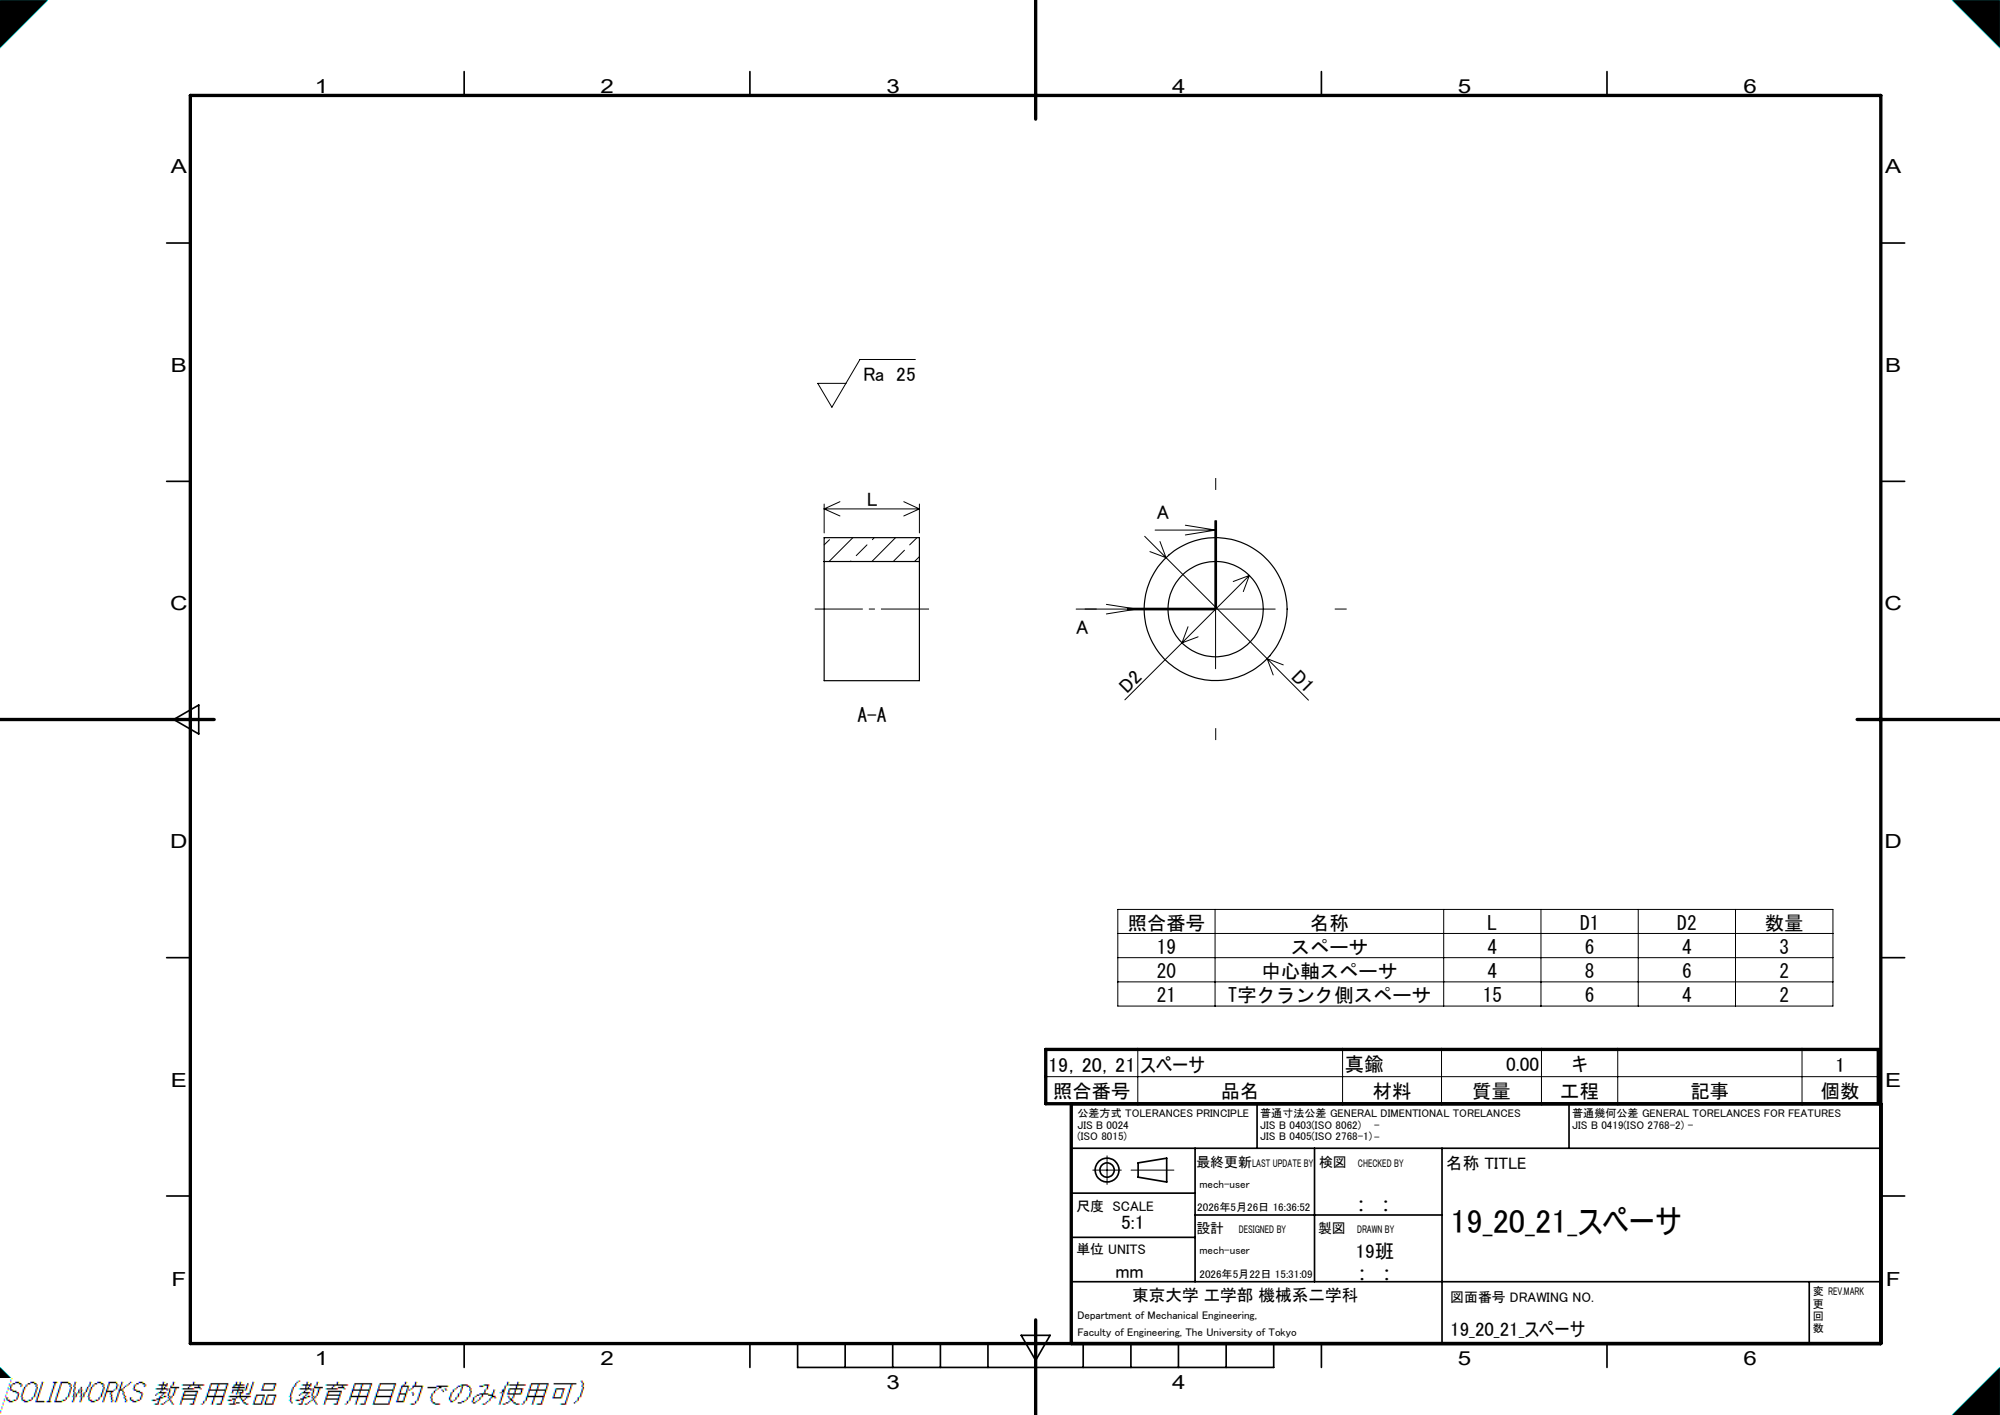
[picture p39: page 1]
尺度 SCALE; 設計 DESIGNED BY; 製図 DRAWN BY; 名称 TITLE; - JIS B 0419(ISO 2768-2)

照合番号 | 名称 | L | D1 | D2 | 数量
19 | スペーサ | 4 | 6 | 4 | 3
20 | 中心軸スペーサ | 4 | 8 | 6 | 2
21 | T字クランク側スペーサ | 15 | 6 | 4 | 2

19，20，21 スペーサ | | 真鍮 | 0.00 | キ | | 1
照合番号 | 品名 | 材料 | 質量 | 工程 | 記事 | 個数

公差方式 TOLERANCES PRINCIPLE
JIS B 0024
(ISO 8015)

普通寸法公差 GENERAL DIMENTIONAL TORELANCES
JIS B 0403(ISO 8062)
JIS B 0405(ISO 2768-1)

普通幾何公差 GENERAL TORELANCES FOR FEATURES

最終更新 LAST UPDATE BY

検図 CHECKED BY

単位 UNITS
東京大学 工学部 機械系二学科

図面番号 DRAWING NO.
19_20_21_スペーサ

Department of Mechanical Engineering,
Faculty of Engineering, The University of Tokyo
